LaibaAsif/FERN/Impact Attenuator/ALUMINIUM IA/core 6x6 t2.SLDASM

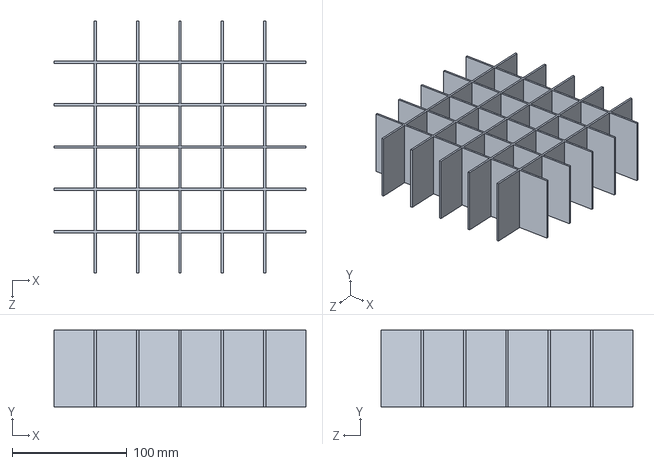
[picture p32: CAD file, 2022-05-04]
Impact Attenuator/ALUMINIUM IA/core 6x6 t2.SLDASM
220.0 x 67.0 x 220.0 mm
core part 6x6 t2 x 10
