LaibaAsif/FERN/Impact Attenuator/ALUMINIUM IA/IA.SLDASM

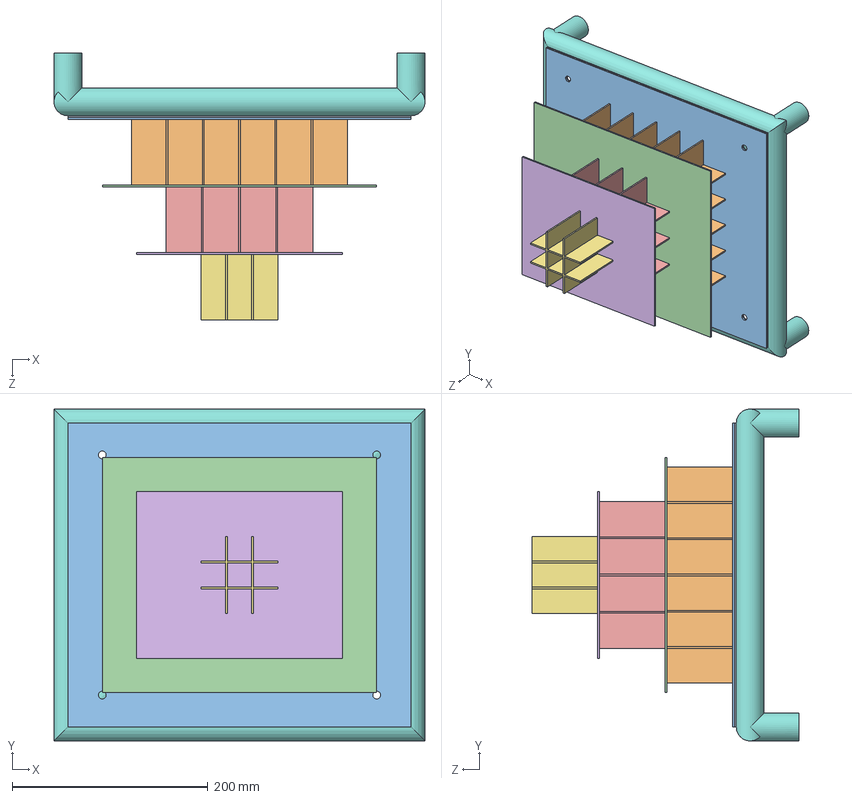
[picture p33: CAD file, 2022-05-04]
Impact Attenuator/ALUMINIUM IA/IA.SLDASM
378.6 x 338.6 x 272.8 mm
core plate bottom
core part 6x6 t2 x 10
AIP Alum sheet
core plate mid - Copy
core part 4x4 t2 x 6
mid layer top
core part 3x3 t2 x 4
bulkhead piece
