LaibaAsif/FERN/Impact Attenuator/FOAM IA TAKE 1/foam IA.SLDASM

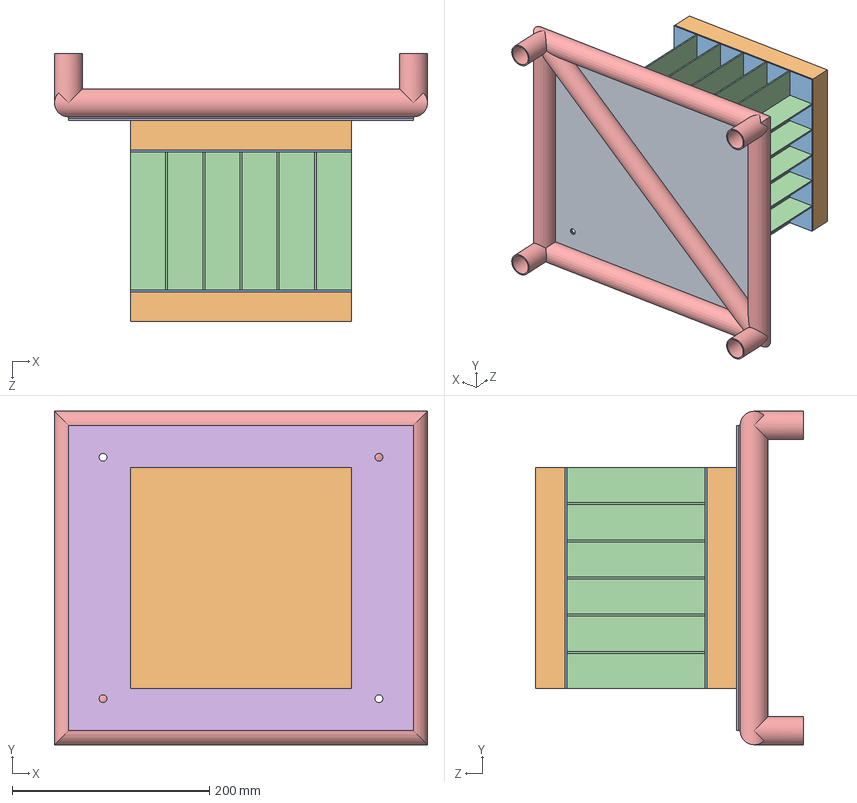
[picture p34: CAD file, 2022-05-04]
Impact Attenuator/FOAM IA TAKE 1/foam IA.SLDASM
378.6 x 338.6 x 271.8 mm
core plate bottom
foam x 2
foam mid plates x 2
FOAM IA 1 PART 6X6 x 10
bulkhead piece
Alum sheet after AIP
