LaibaAsif/FERN/Impact Attenuator/ALUMINIUM IA/core 4x4 t2.SLDASM

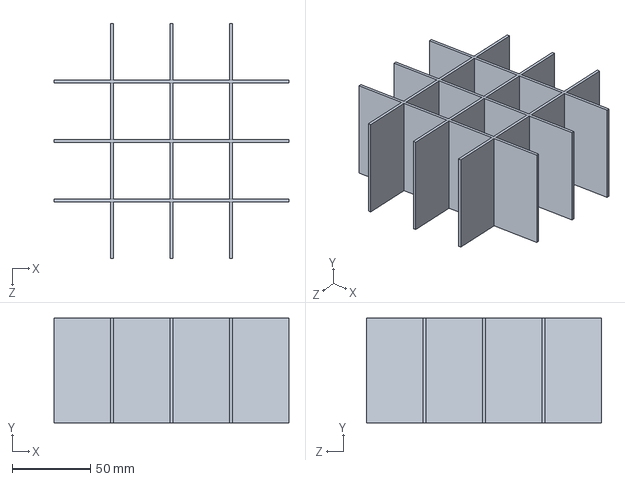
[picture p35: CAD file, 2022-05-04]
Impact Attenuator/ALUMINIUM IA/core 4x4 t2.SLDASM
150.0 x 67.0 x 150.0 mm
core part 4x4 t2 x 6
