LaibaAsif/FERN/Impact Attenuator/FOAM IA TAKE 1/FOAM IA 1 CORE 6X6.SLDASM

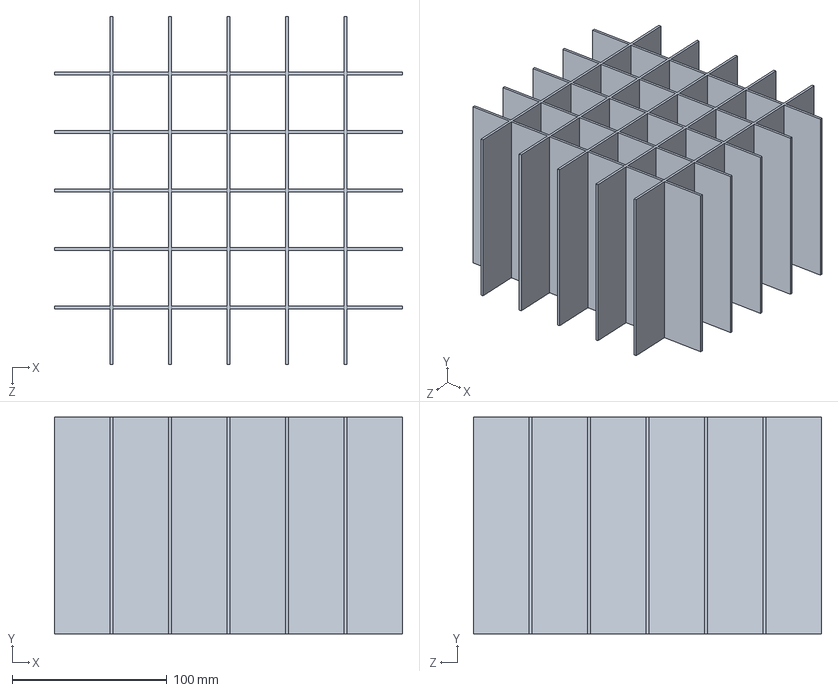
[picture p36: CAD file, 2022-05-04]
Impact Attenuator/FOAM IA TAKE 1/FOAM IA 1 CORE 6X6.SLDASM
224.6 x 140.0 x 224.6 mm
FOAM IA 1 PART 6X6 x 10
