LaibaAsif/FERN/Impact Attenuator/ALUMINIUM IA/core 3x3 t2.SLDASM

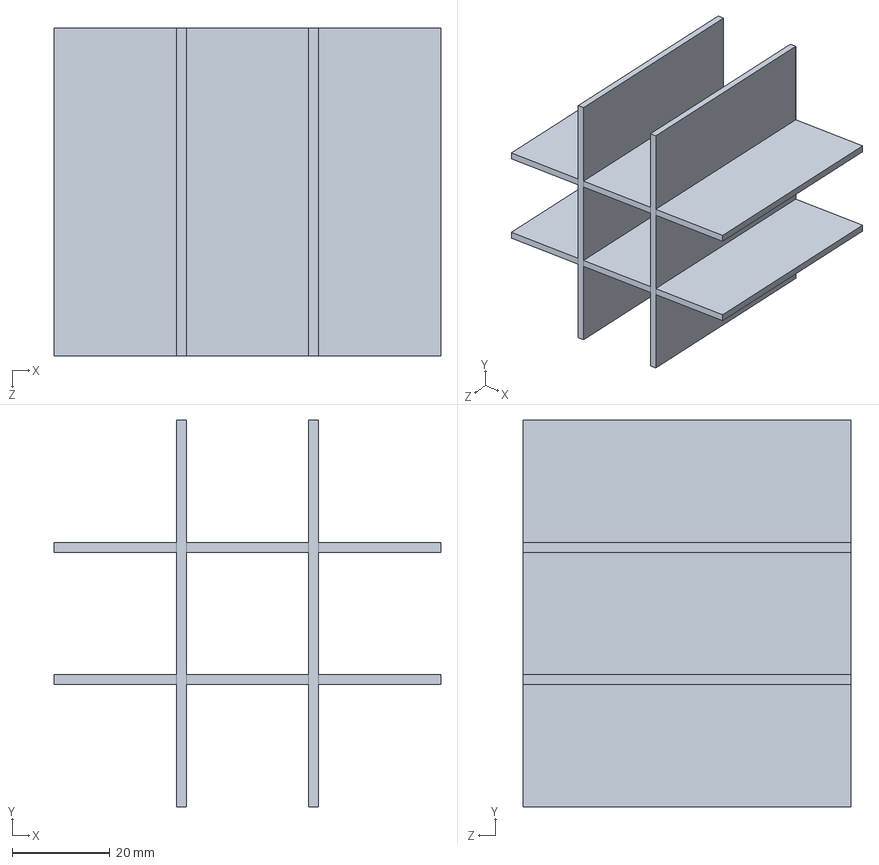
[picture p37: CAD file, 2022-05-04]
Impact Attenuator/ALUMINIUM IA/core 3x3 t2.SLDASM
79.0 x 79.0 x 67.0 mm
core part 3x3 t2 x 4
