LaibaAsif/FERN/Impact Attenuator/ALUMINIUM IA/core part 3x3 t2.SLDPRT

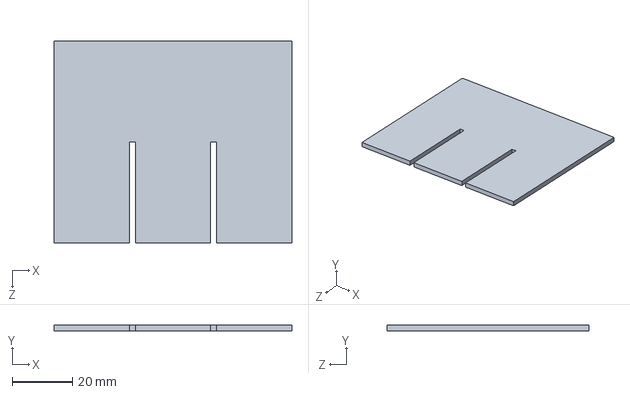
[picture p38: CAD file, 2022-05-04]
Impact Attenuator/ALUMINIUM IA/core part 3x3 t2.SLDPRT
79.0 x 2.00 x 67.0 mm
