LaibaAsif/FERN/Impact Attenuator/FOAM IA TAKE 1/core plate bottom.SLDPRT

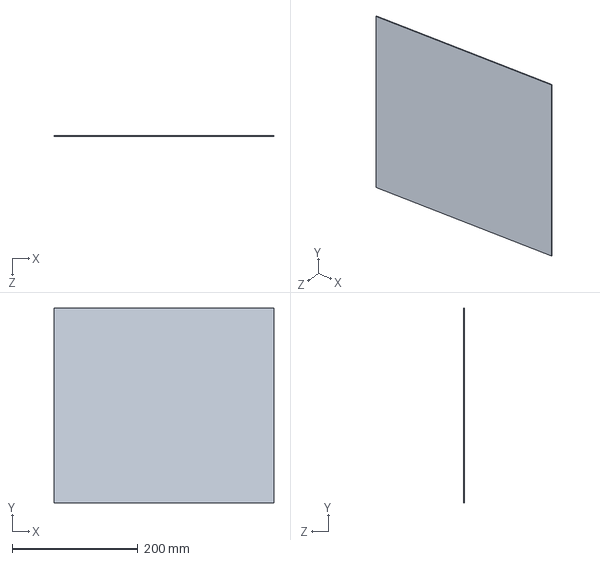
[picture p39: CAD file, 2022-05-04]
Impact Attenuator/FOAM IA TAKE 1/core plate bottom.SLDPRT
350.0 x 310.0 x 1.50 mm
