LaibaAsif/FERN/Impact Attenuator/FOAM IA TAKE 2/core(6x6).SLDPRT

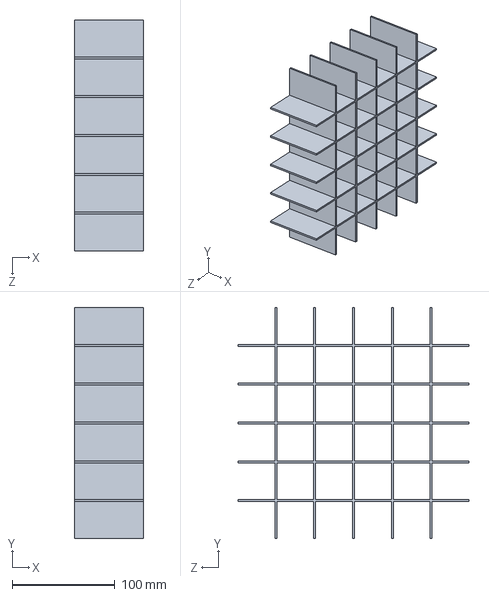
[picture p40: CAD file, 2022-05-04]
Impact Attenuator/FOAM IA TAKE 2/core(6x6).SLDPRT
67.0 x 224.6 x 224.6 mm
