LaibaAsif/FERN/Impact Attenuator/FOAM IA TAKE 3/AIP Alum sheet.SLDPRT

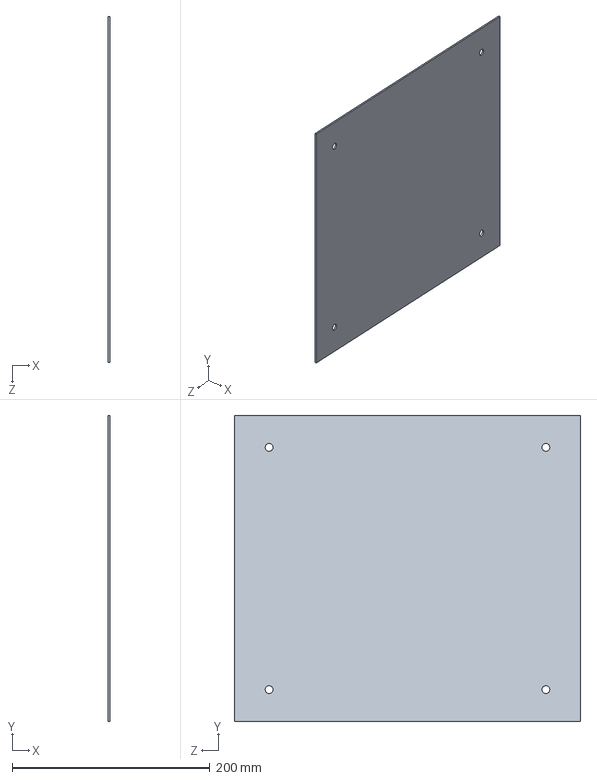
[picture p41: CAD file, 2022-05-04]
Impact Attenuator/FOAM IA TAKE 3/AIP Alum sheet.SLDPRT
2.00 x 310.0 x 350.0 mm
