LaibaAsif/FERN/meri chassis.SLDPRT

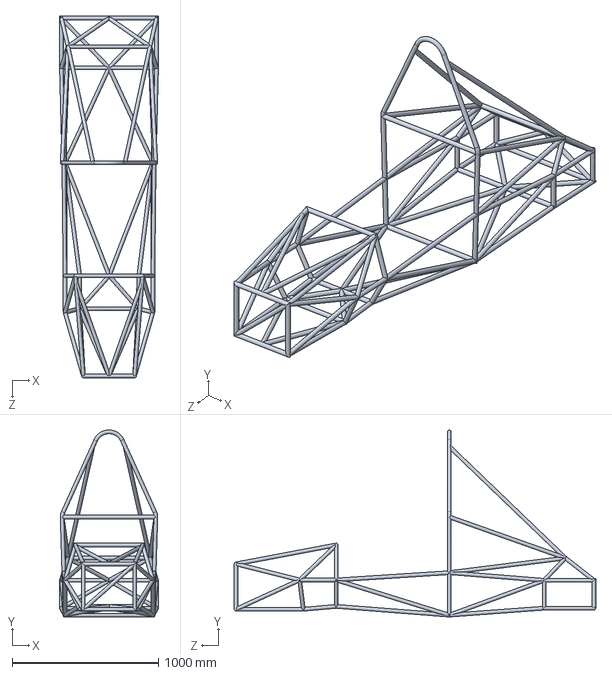
[picture p42: CAD file, 2022-05-04]
meri chassis.SLDPRT
675.4 x 1277.4 x 2470.0 mm
