LaibaAsif/FERN/Impact Attenuator/FOAM IA TAKE 1/front foam.SLDPRT

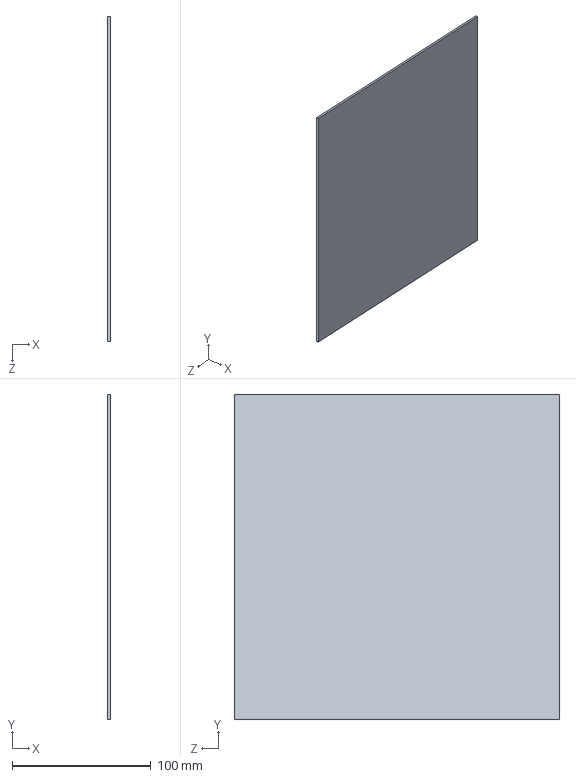
[picture p43: CAD file, 2022-05-04]
Impact Attenuator/FOAM IA TAKE 1/front foam.SLDPRT
2.00 x 234.6 x 234.6 mm
