LaibaAsif/FERN/Impact Attenuator/FOAM IA TAKE 2/core part 6x6 t2.SLDPRT

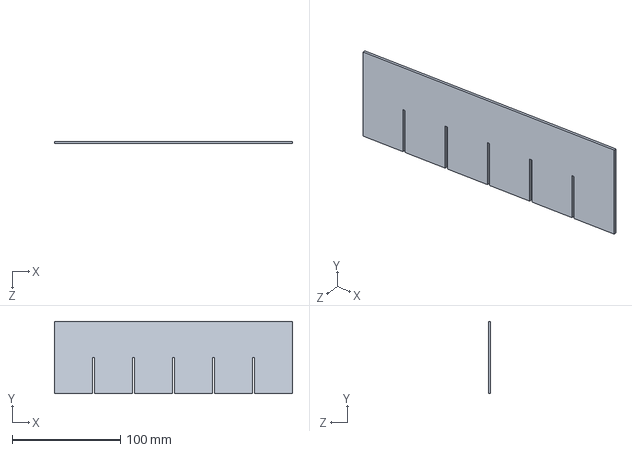
[picture p44: CAD file, 2022-05-04]
Impact Attenuator/FOAM IA TAKE 2/core part 6x6 t2.SLDPRT
220.0 x 67.0 x 2.00 mm
