LaibaAsif/FERN/Impact Attenuator/FOAM IA TAKE 3/FOAM 4.SLDPRT

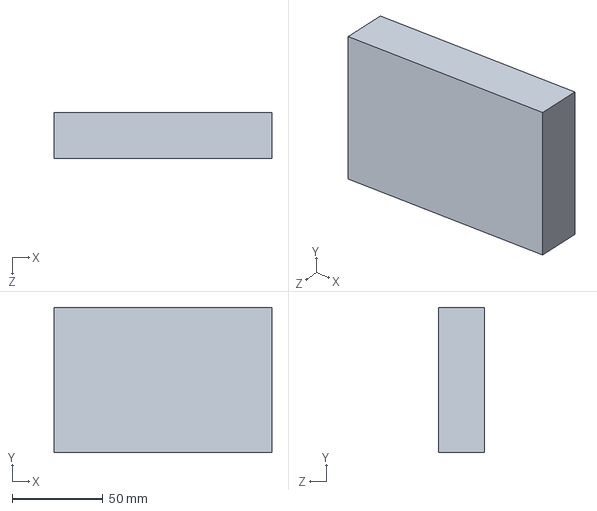
[picture p45: CAD file, 2022-05-04]
Impact Attenuator/FOAM IA TAKE 3/FOAM 4.SLDPRT
120.0 x 80.0 x 25.4 mm
