LaibaAsif/FERN/Impact Attenuator/ALUMINIUM IA/bulkhead piece.SLDPRT

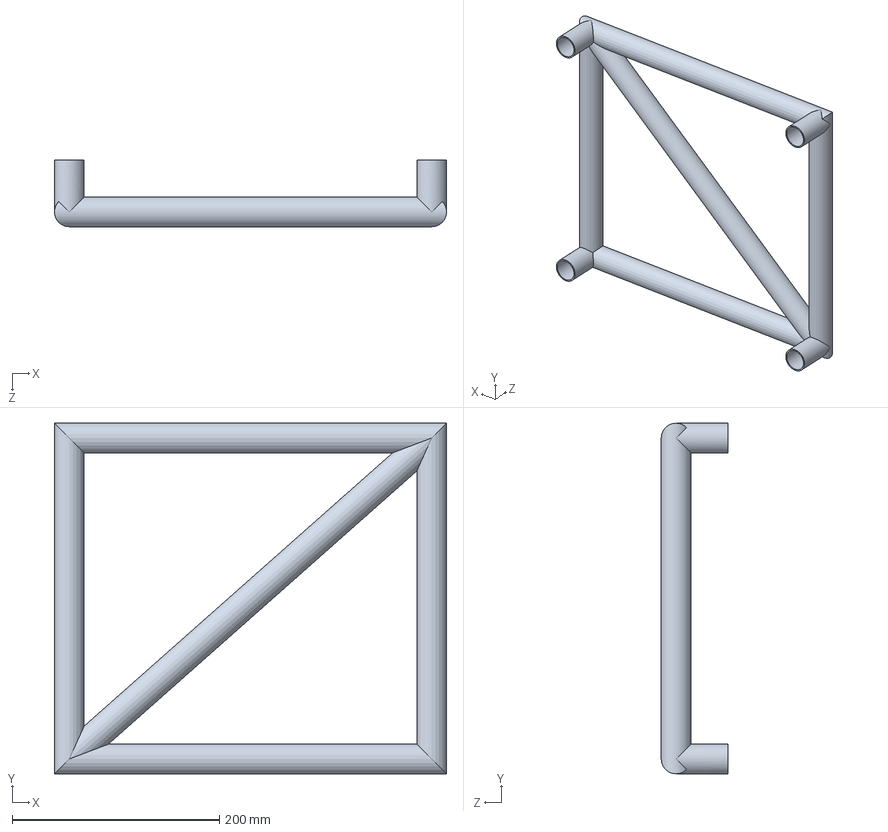
[picture p46: CAD file, 2022-05-04]
Impact Attenuator/ALUMINIUM IA/bulkhead piece.SLDPRT
378.6 x 338.6 x 64.3 mm
