LaibaAsif/FERN/Impact Attenuator/FOAM IA TAKE 1/core(6x6) foam.SLDPRT

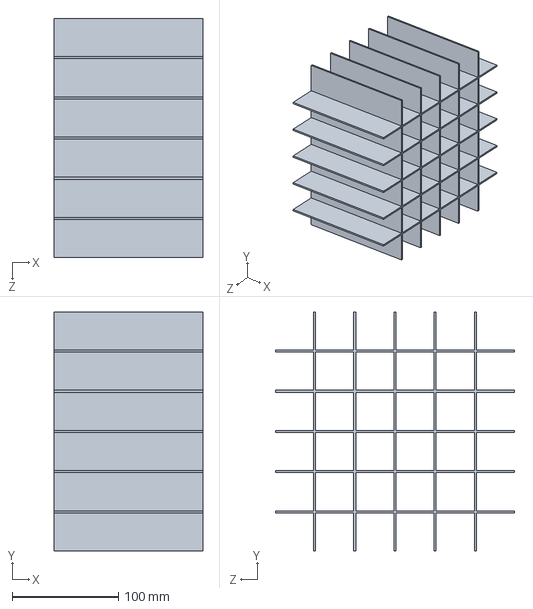
[picture p47: CAD file, 2022-05-04]
Impact Attenuator/FOAM IA TAKE 1/core(6x6) foam.SLDPRT
140.0 x 224.6 x 224.6 mm
