LaibaAsif/FERN/Impact Attenuator/FOAM IA TAKE 2/cover lid.SLDPRT

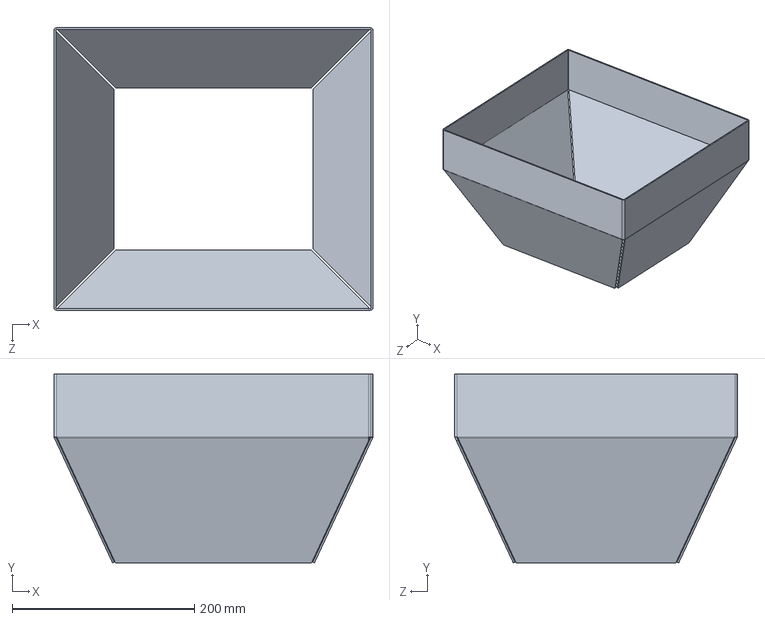
[picture p48: CAD file, 2022-05-04]
Impact Attenuator/FOAM IA TAKE 2/cover lid.SLDPRT
350.0 x 207.3 x 310.0 mm
