LaibaAsif/FERN/Impact Attenuator/FOAM IA TAKE 3/FOAM IA.STEP

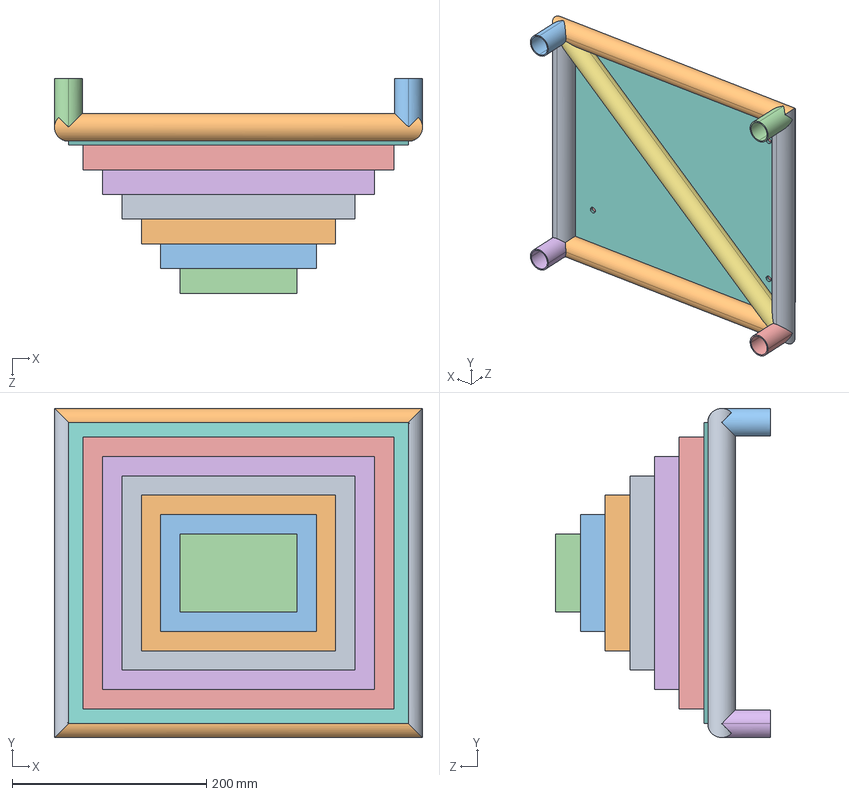
[picture p49: CAD file, 2022-05-04]
Impact Attenuator/FOAM IA TAKE 3/FOAM IA.STEP
378.6 x 338.6 x 220.7 mm
bulkhead piece_Default<As Machined>
AIP Alum sheet
Alum sheet after AIP
FOAM 1
FOAM 2
FOAM 3
FOAM 4
FOAM -2
FOAM -1
