LaibaAsif/FERN/Impact Attenuator/FOAM IA TAKE 1/foam mid plates.SLDPRT

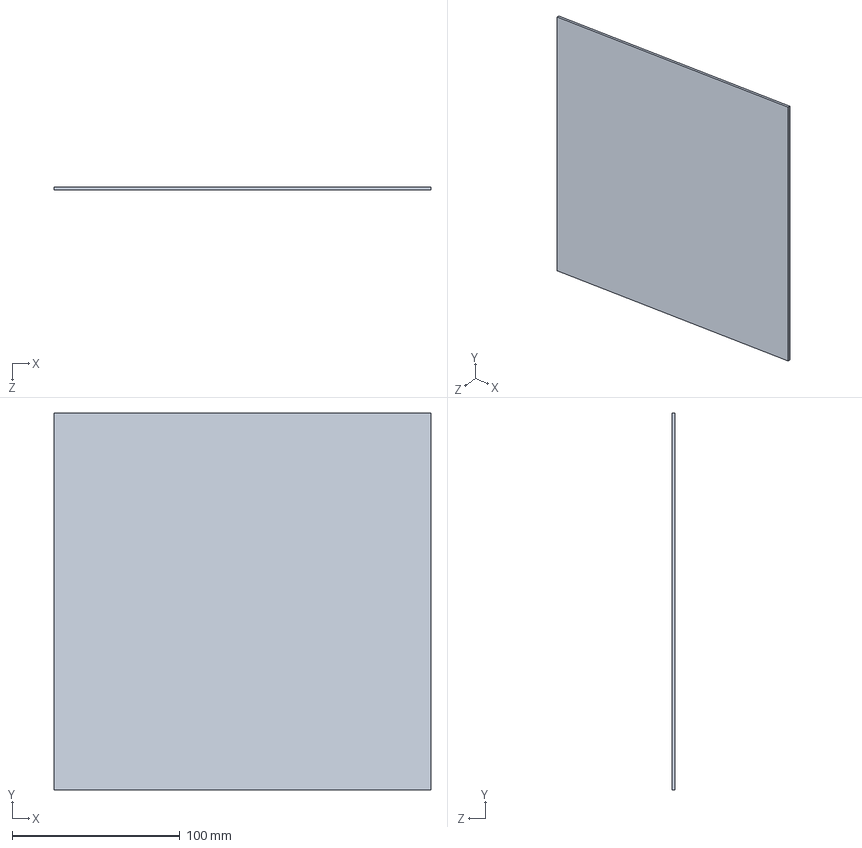
[picture p50: CAD file, 2022-05-04]
Impact Attenuator/FOAM IA TAKE 1/foam mid plates.SLDPRT
224.6 x 224.6 x 2.00 mm
