LaibaAsif/FERN/Impact Attenuator/FOAM IA TAKE 2/cover foam take 3.SLDPRT

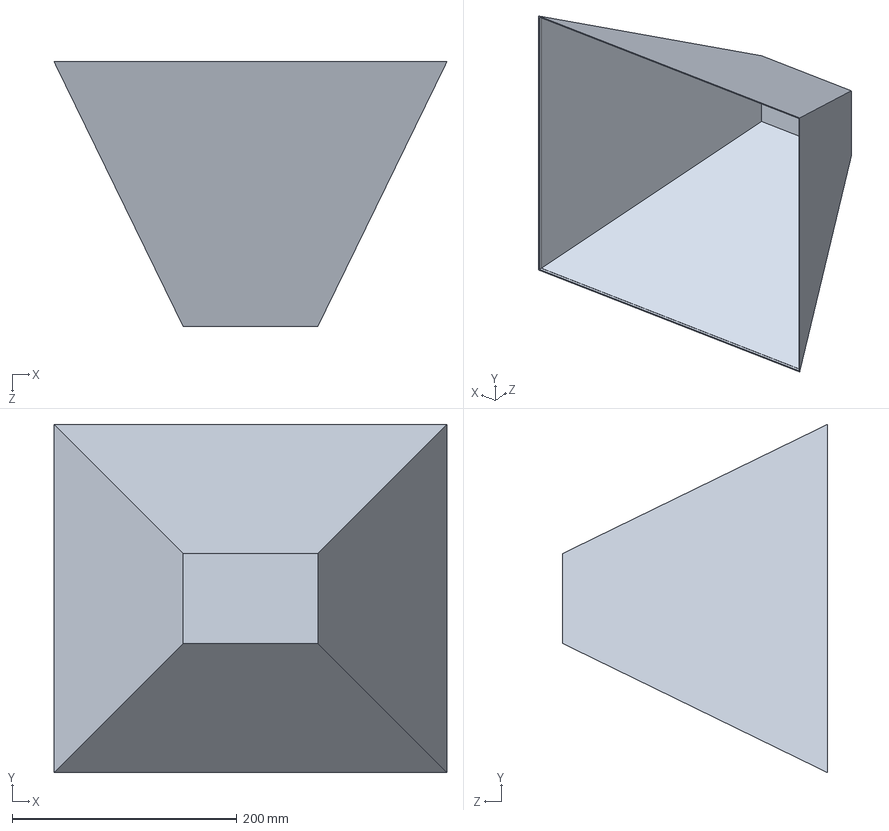
[picture p51: CAD file, 2022-05-04]
Impact Attenuator/FOAM IA TAKE 2/cover foam take 3.SLDPRT
350.0 x 310.0 x 235.7 mm
