LaibaAsif/FERN/Impact Attenuator/FOAM IA TAKE 3/FOAM -1.SLDPRT

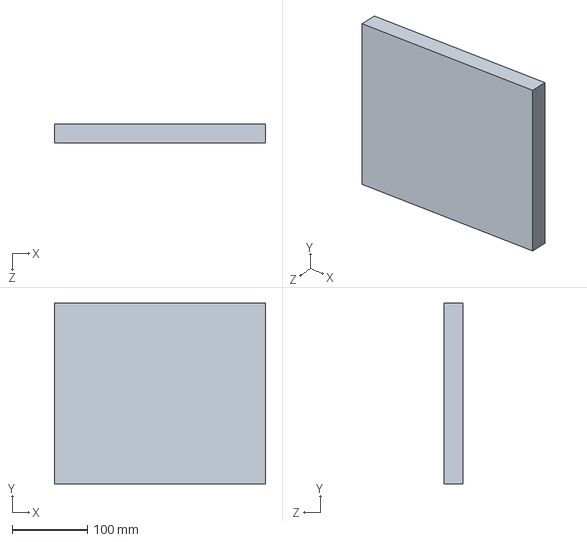
[picture p52: CAD file, 2022-05-04]
Impact Attenuator/FOAM IA TAKE 3/FOAM -1.SLDPRT
280.0 x 240.0 x 25.4 mm
