LaibaAsif/FERN/Impact Attenuator/ALUMINIUM IA/core part 4x4 t2.SLDPRT

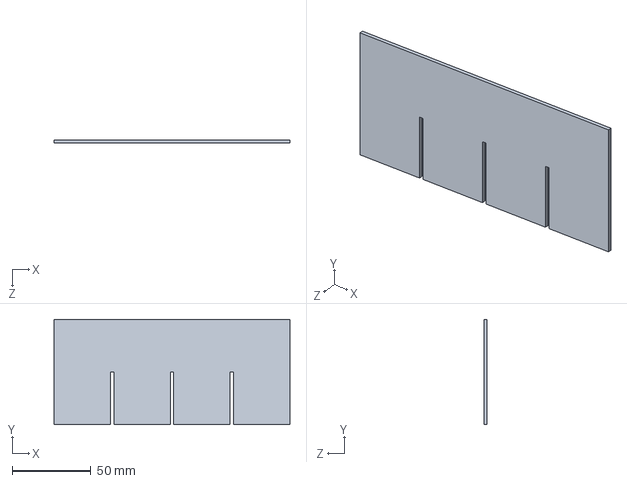
[picture p53: CAD file, 2022-05-04]
Impact Attenuator/ALUMINIUM IA/core part 4x4 t2.SLDPRT
150.0 x 67.0 x 2.00 mm
