LaibaAsif/FERN/Impact Attenuator/FOAM IA TAKE 1/FOAM IA 1 PART 6X6.SLDPRT

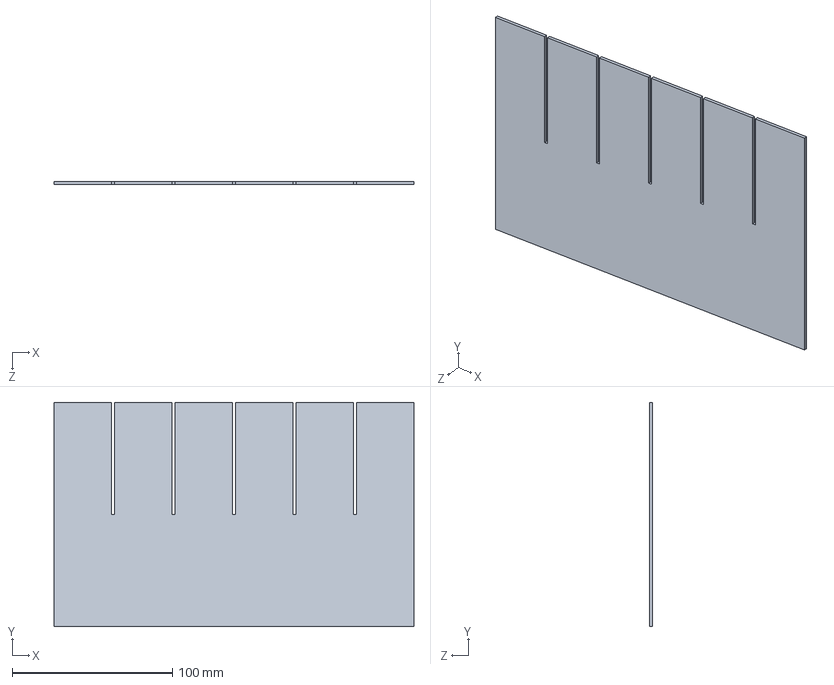
[picture p54: CAD file, 2022-05-04]
Impact Attenuator/FOAM IA TAKE 1/FOAM IA 1 PART 6X6.SLDPRT
224.6 x 140.0 x 2.00 mm
