LaibaAsif/FERN/Impact Attenuator/FOAM IA TAKE 2/FOAM 3.SLDPRT

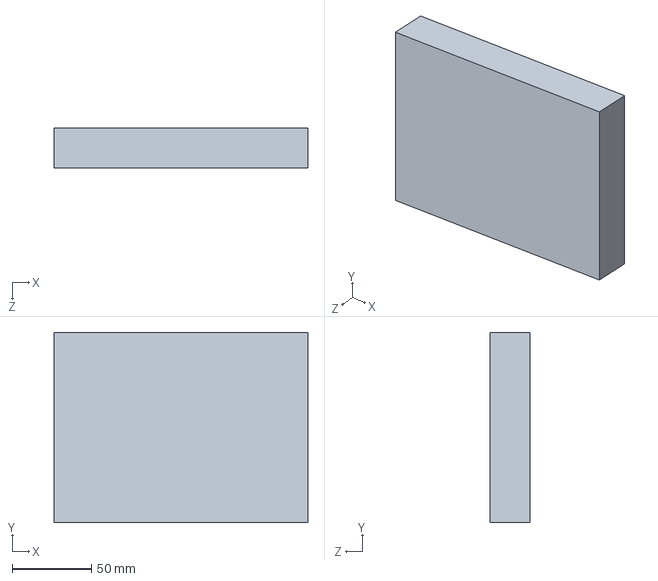
[picture p55: CAD file, 2022-05-04]
Impact Attenuator/FOAM IA TAKE 2/FOAM 3.SLDPRT
160.0 x 120.0 x 25.4 mm
