LaibaAsif/FERN/Impact Attenuator/FOAM IA TAKE 2/foam cover take 3 (2).SLDPRT

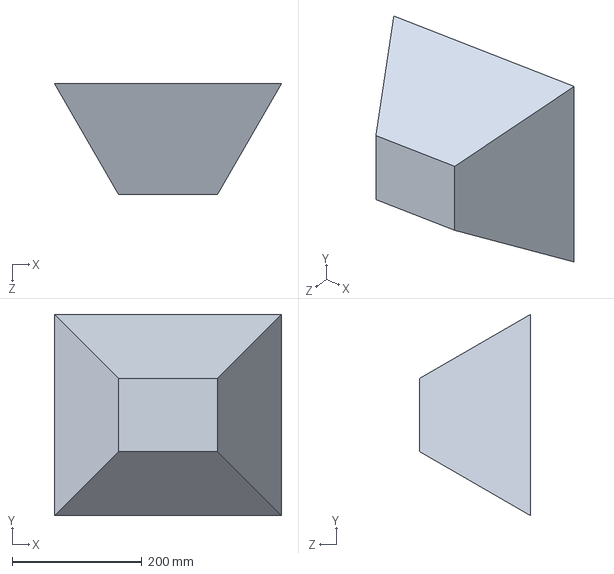
[picture p56: CAD file, 2022-05-04]
Impact Attenuator/FOAM IA TAKE 2/foam cover take 3 (2).SLDPRT
350.0 x 310.0 x 170.6 mm
