LaibaAsif/FERN/Impact Attenuator/FOAM IA TAKE 1/foam.SLDPRT

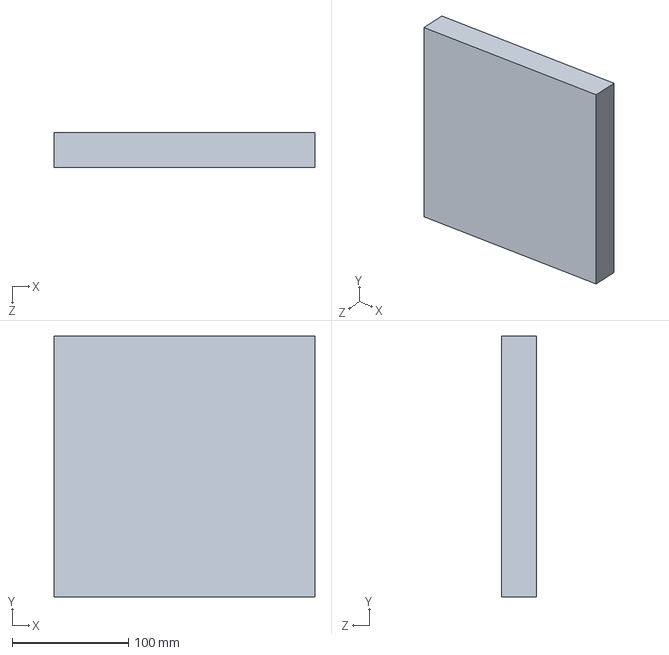
[picture p57: CAD file, 2022-05-04]
Impact Attenuator/FOAM IA TAKE 1/foam.SLDPRT
224.6 x 224.6 x 30.0 mm
