LaibaAsif/FERN/Impact Attenuator/FOAM IA TAKE 2/flaps.SLDPRT

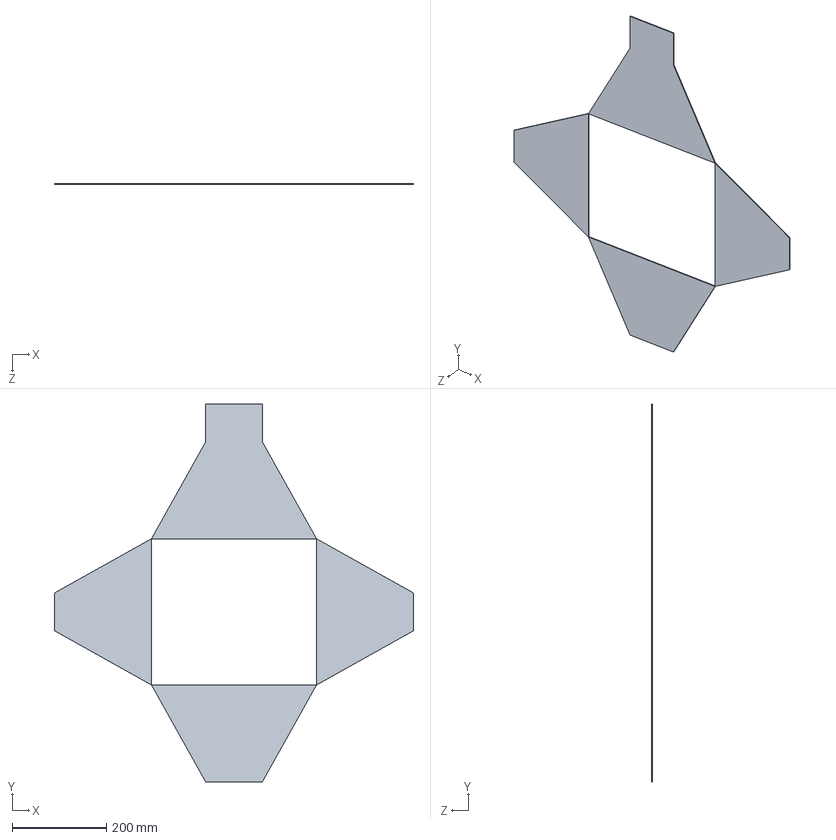
[picture p58: CAD file, 2022-05-04]
Impact Attenuator/FOAM IA TAKE 2/flaps.SLDPRT
761.5 x 801.5 x 2.00 mm
