LaibaAsif/FERN/Impact Attenuator/FOAM IA TAKE 3/FOAM -2.SLDPRT

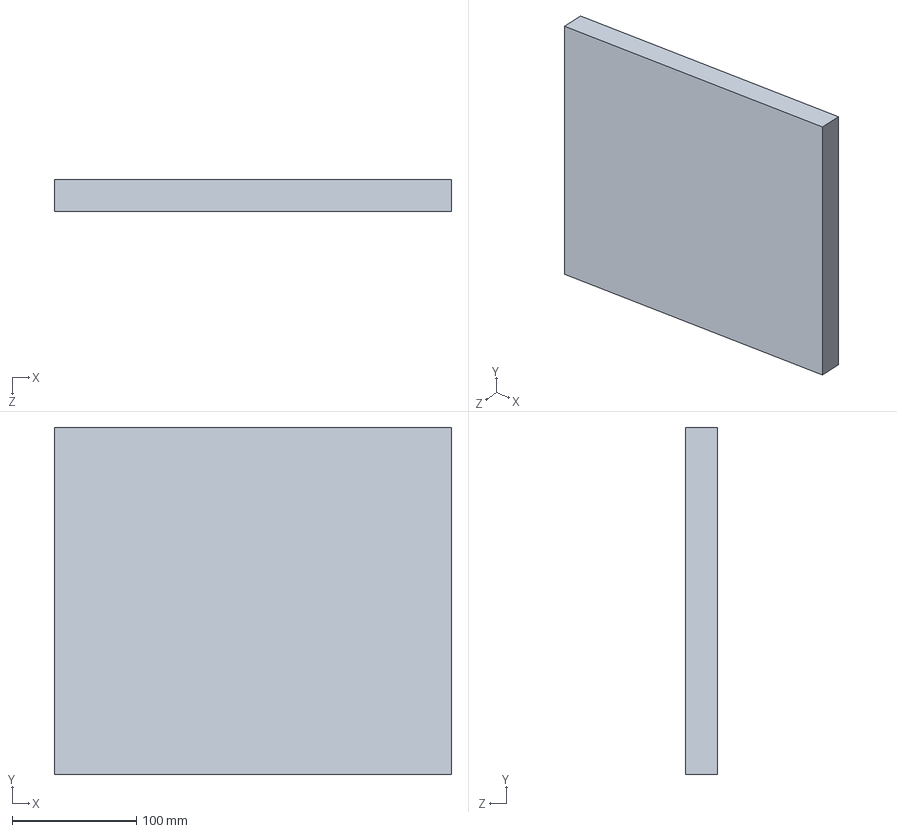
[picture p59: CAD file, 2022-05-04]
Impact Attenuator/FOAM IA TAKE 3/FOAM -2.SLDPRT
320.0 x 280.0 x 25.4 mm
