LaibaAsif/FERN/Impact Attenuator/ALUMINIUM IA/core top layer.SLDPRT

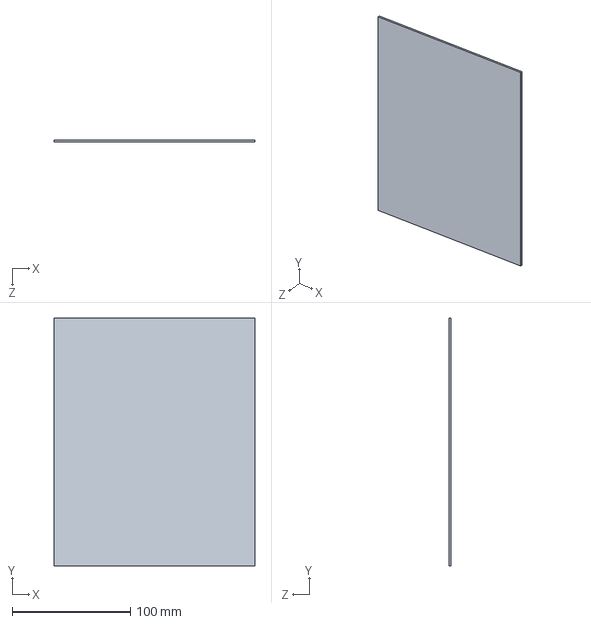
[picture p60: CAD file, 2022-05-04]
Impact Attenuator/ALUMINIUM IA/core top layer.SLDPRT
170.0 x 210.0 x 2.00 mm
