LaibaAsif/FERN/Impact Attenuator/FOAM IA TAKE 2/FOAM 2.SLDPRT

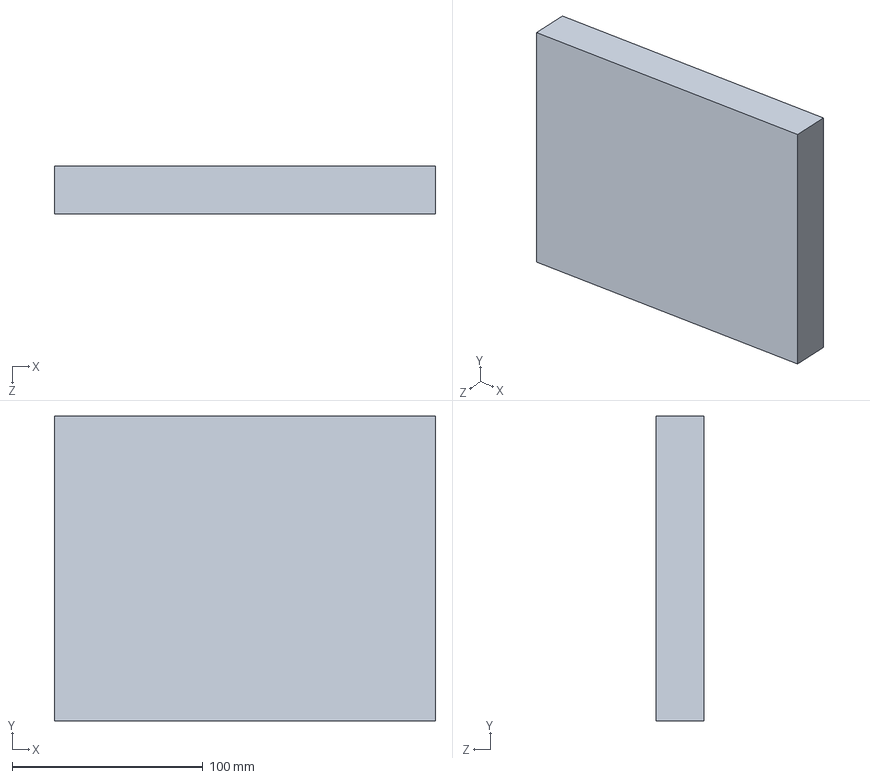
[picture p61: CAD file, 2022-05-04]
Impact Attenuator/FOAM IA TAKE 2/FOAM 2.SLDPRT
200.0 x 160.0 x 25.4 mm
