LaibaAsif/FERN/Impact Attenuator/FOAM IA TAKE 2/FOAM 1.SLDPRT

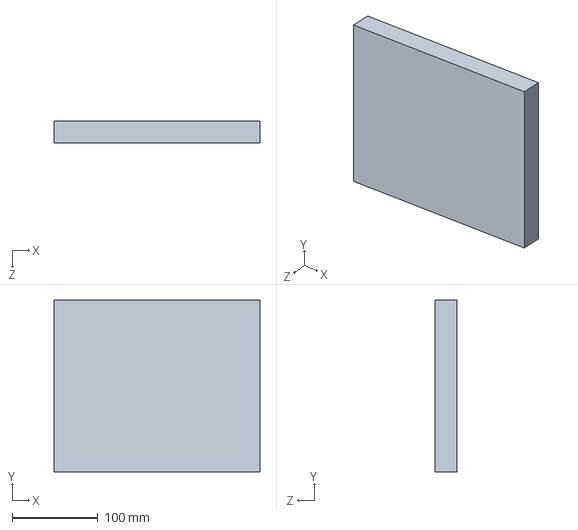
[picture p62: CAD file, 2022-05-04]
Impact Attenuator/FOAM IA TAKE 2/FOAM 1.SLDPRT
240.0 x 200.0 x 25.4 mm
