LaibaAsif/FERN/Impact Attenuator/ALUMINIUM IA/core plate mid - Copy.SLDPRT

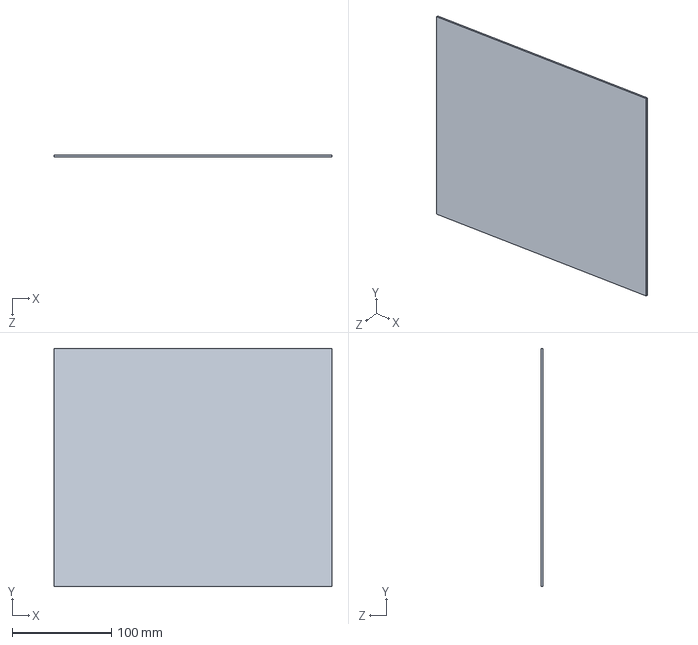
[picture p63: CAD file, 2022-05-04]
Impact Attenuator/ALUMINIUM IA/core plate mid - Copy.SLDPRT
280.0 x 240.0 x 2.00 mm
