LaibaAsif/FERN/Impact Attenuator/FOAM IA TAKE 2/foam IA.STEP

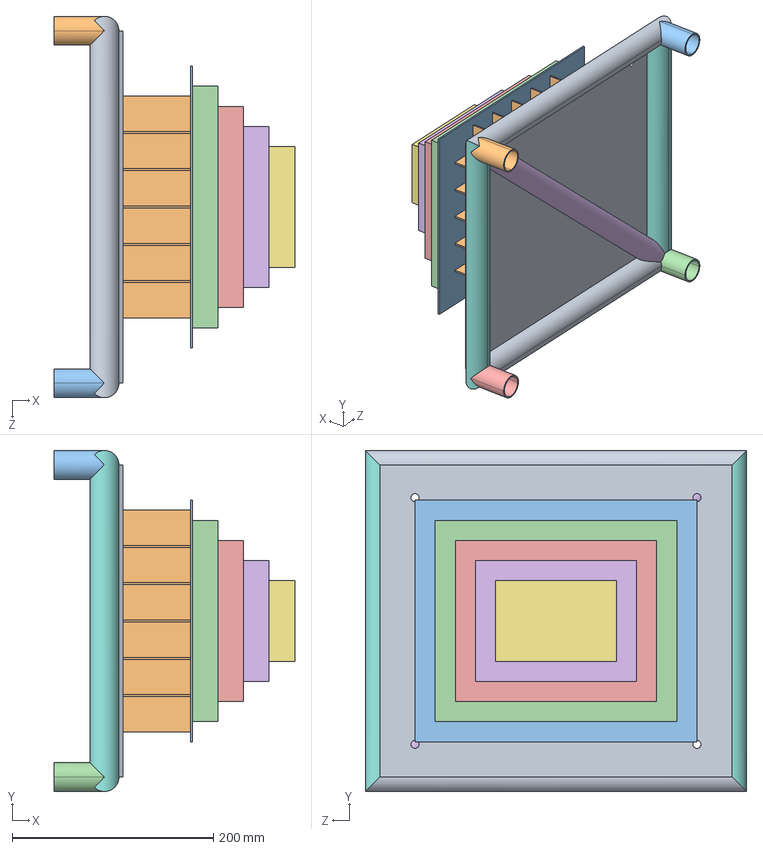
[picture p64: CAD file, 2022-05-04]
Impact Attenuator/FOAM IA TAKE 2/foam IA.STEP
238.9 x 338.6 x 378.6 mm
AIP Alum sheet
al sheet after aip
core part 6x6 t2 x 10
sheet bw core and foam
FOAM 1
FOAM 2
FOAM 3
FOAM 4
bulkhead piece_Default<As Machined>
