LaibaAsif/FERN/(list of files, cad)

Other CAD files:
Impact Attenuator/FOAM IA TAKE 2/core 6x6 t2.SLDASM
Impact Attenuator/ALUMINIUM IA/AIP Alum sheet.SLDPRT
Impact Attenuator/FOAM IA TAKE 3/Alum sheet after AIP.SLDPRT
Impact Attenuator/FOAM IA TAKE 1/foam front plate.SLDPRT
Impact Attenuator/FOAM IA TAKE 2/AIP Alum sheet.SLDPRT
Impact Attenuator/FOAM IA TAKE 2/sheet bw core and foam.SLDPRT
Impact Attenuator/ALUMINIUM IA/mid layer top.SLDPRT
Impact Attenuator/FOAM IA TAKE 2/Alum sheet after AIP.SLDPRT
Impact Attenuator/FOAM IA TAKE 2/foam IA.SLDASM
Impact Attenuator/FOAM IA TAKE 3/FOAM IA.SLDASM
